waldeir/washing_machine/wash_machine.sch

## EAGLE design wash_machine.sch (2021-09-11)

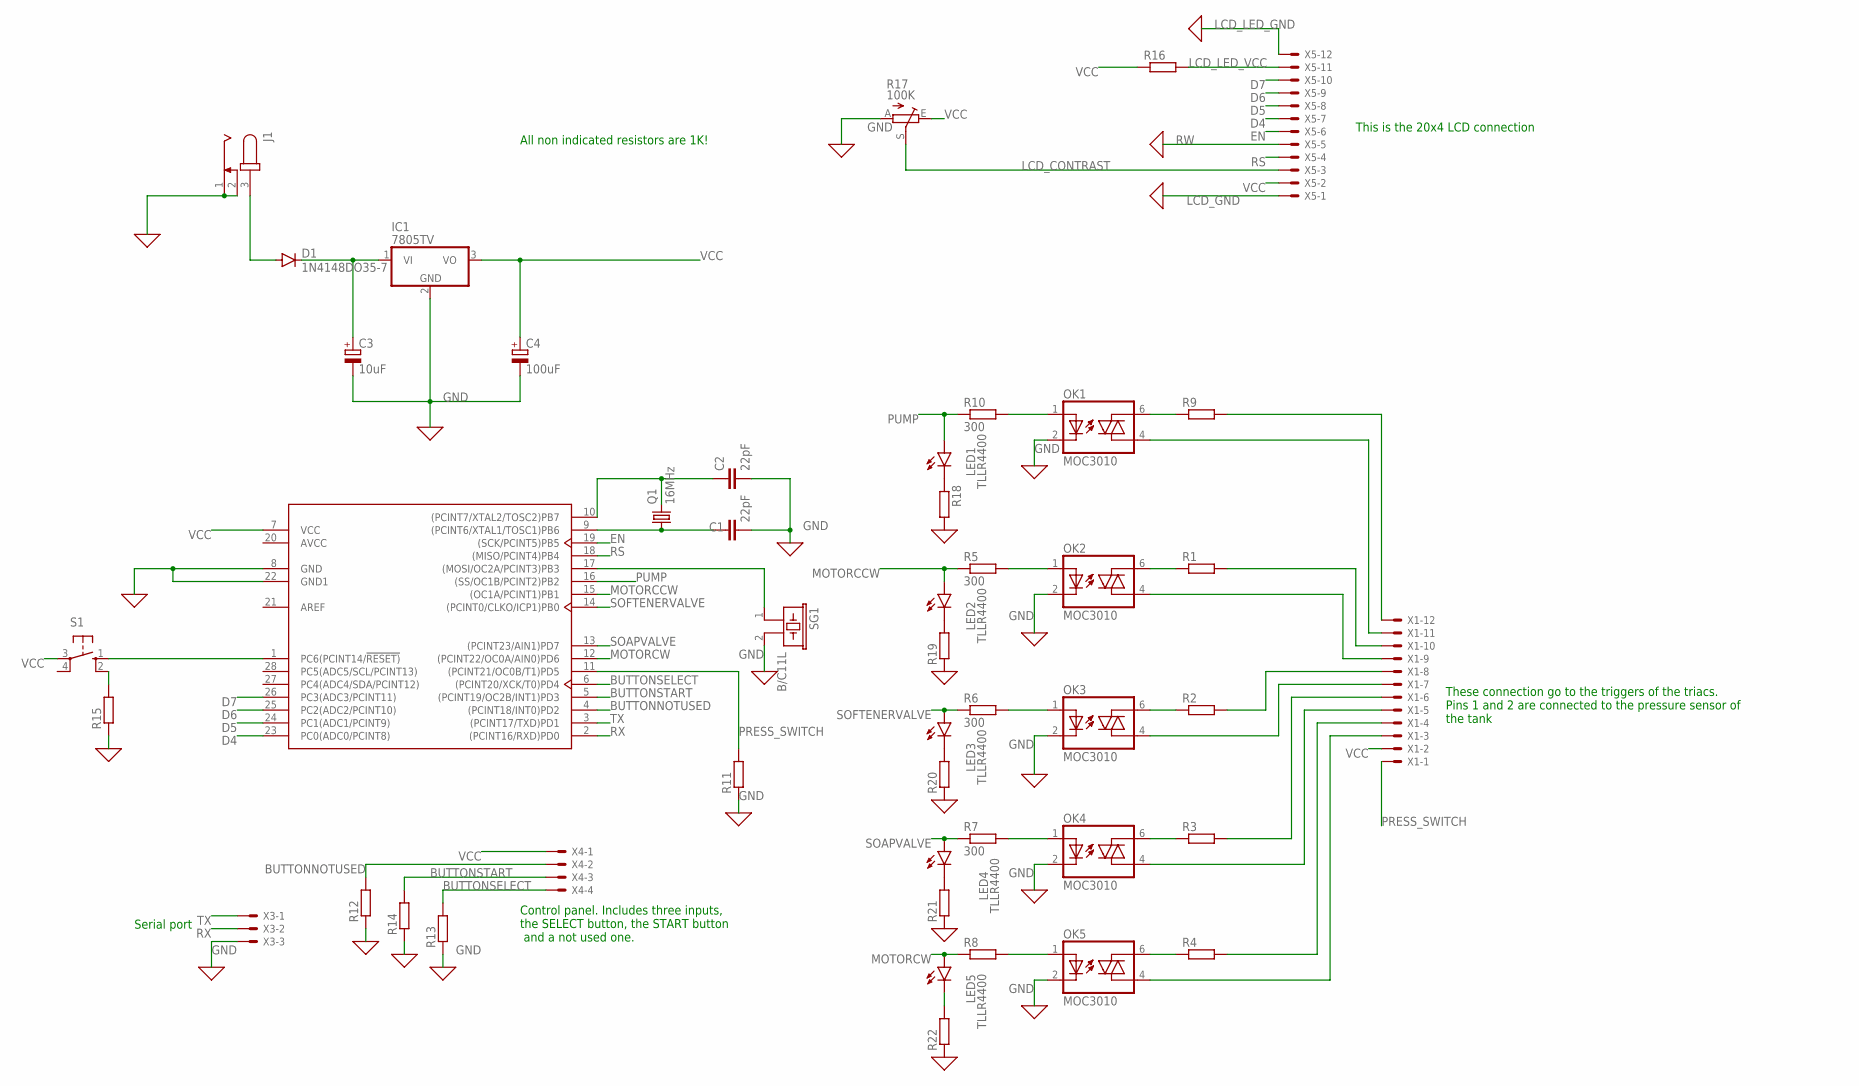
[picture p1: schematic wash_machine.sch]

Parts:
C1, C2: 22pF; C2.5-3
C3: 10uF; B45181A
C4: 100uF; B45181A
D1: 1N4148DO35-7; DO35-7
IC1: 7805TV; TO220V
J1: JACK-PLUG0; SPC4077
LED1, LED2, LED3, LED4, LED5: TLLR4400; LED3MM
OK1, OK2, OK3, OK4, OK5: MOC3010; DIL06
Q1: 16MHz; HC49U-V
R1, R2, R3, R4, R8, R9, R11, R12, R13, R14, R15, R16, R18, R19, R20, R21, R22: R-EU_0204/7; 0204/7
R5, R6, R7, R10: 300; 0204/7
R17: 100K; B25U
S1: 10-XX; B3F-10XX
SG1: B/C11L
U1: ATMEGA328P-PU; DIP-28
X1, X5: KK-156-12
X3: KK-156-3
X4: KK-156-4

Connections:
BUTTONNOTUSED: R12.2, U1.4 ((PCINT18/INT0)PD2), X4.2
BUTTONSELECT: R13.2, U1.6 ((PCINT20/XCK/T0)PD4), X4.4
BUTTONSTART: R14.2, U1.5 ((PCINT19/OC2B/INT1)PD3), X4.3
D4: U1.23 (PC0(ADC0/PCINT8)), X5.7
D5: U1.24 (PC1(ADC1/PCINT9)), X5.8
D6: U1.25 (PC2(ADC2/PCINT10)), X5.9
D7: U1.26 (PC3(ADC3/PCINT11)), X5.10
EN: U1.19 ((SCK/PCINT5)PB5), X5.6
GND: C1.2, C2.2, C3.-, C4.-, IC1.2 (GND), J1.1, J1.2, OK1.2 (C), OK2.2 (C), OK3.2 (C), OK4.2 (C), OK5.2 (C), R11.1, R12.1, R13.1, R14.1, R15.1, R17.A, R18.2, R19.1, R20.1, R21.1, R22.1, SG1.2, U1.8 (GND), U1.22 (GND1), X3.3
LCD_CONTRAST: R17.S, X5.3
LCD_GND: X5.1
LCD_LED_GND: X5.12
LCD_LED_VCC: R16.2, X5.11
MOTORCCW: LED2.A, R5.1, U1.15 ((OC1A/PCINT1)PB1)
MOTORCW: LED5.A, R8.1, U1.12 ((PCINT22/OC0A/AIN0)PD6)
unnamed: D1.A, J1.3
unnamed: C3.+, D1.C, IC1.1 (VI)
unnamed: SG1.1, U1.17 ((MOSI/OC2A/PCINT3)PB3)
unnamed: OK5.1 (A), R8.2
unnamed: C1.1, Q1.1, U1.9 ((PCINT6/XTAL1/TOSC1)PB6)
unnamed: C2.1, Q1.2, U1.10 ((PCINT7/XTAL2/TOSC2)PB7)
unnamed: OK4.1 (A), R7.2
unnamed: OK3.1 (A), R6.2
unnamed: OK2.1 (A), R5.2
unnamed: OK1.6 (A2), R9.1
unnamed: OK2.6 (A2), R1.1
unnamed: OK3.6 (A2), R2.1
unnamed: OK4.6 (A2), R3.1
unnamed: OK1.1 (A), R10.2
unnamed: OK5.6 (A2), R4.1
unnamed: R9.2, X1.12
unnamed: OK1.4 (A1), X1.11
unnamed: R1.2, X1.10
unnamed: OK2.4 (A1), X1.9
unnamed: R2.2, X1.8
unnamed: OK3.4 (A1), X1.7
unnamed: R3.2, X1.6
unnamed: OK4.4 (A1), X1.5
unnamed: R4.2, X1.4
unnamed: OK5.4 (A1), X1.3
unnamed: S1.1 (S), U1.1 (PC6(PCINT14/!RESET))
unnamed: R15.2, S1.2 (S1)
unnamed: LED1.K (C), R18.1
unnamed: LED2.K (C), R19.2
unnamed: LED3.K (C), R20.2
unnamed: LED4.K (C), R21.2
unnamed: LED5.K (C), R22.2
PRESS_SWITCH: R11.2, U1.11 ((PCINT21/OC0B/T1)PD5), X1.1
PUMP: LED1.A, R10.1, U1.16 ((SS/OC1B/PCINT2)PB2)
RS: U1.18 ((MISO/PCINT4)PB4), X5.4
RW: X5.5
RX: U1.2 ((PCINT16/RXD)PD0), X3.2
SOAPVALVE: LED4.A, R7.1, U1.13 ((PCINT23/AIN1)PD7)
SOFTENERVALVE: LED3.A, R6.1, U1.14 ((PCINT0/CLKO/ICP1)PB0)
TX: U1.3 ((PCINT17/TXD)PD1), X3.1
VCC: C4.+, IC1.3 (VO), R16.1, R17.E, S1.3, U1.7 (VCC), X1.2, X4.1, X5.2

Notes on the sheet:
This is the 20x4 LCD connection
Serial port
Control panel. Includes three inputs, the SELECT button, the START button and a not used one.
These connection go to the triggers of the triacs. Pins 1 and 2 are connected to the pressure sensor of the tank
All non indicated resistors are 1K!
