waldeir/washing_machine/(commit log)

2018-07-05 I noticed that the sprints off time at centrifugation step were too long so I decrease them.
    [washing_machine.ino]
2018-07-20 Eliminating serial print for Time.
2018-07-27 Adding error message in case the tank take too long to fill.
    [washing_machine.ino]
2018-07-31 Print the firmware version.
2018-07-31 Menu list and firmware print correction.
    [washing_machine.ino]
2018-08-15 Corrected:
    Valve not stopping after error message;
    Name of cicle "ENXAGUE DUPLO" is displaying as "ENXAGUE SIMPLES";
    "LAVAGEM COMPLETA" cycle finishes too early.
    [washing_machine.ino]
2018-12-24 motor pin variable descriptions
2019-07-19 Firmware print current firmware version
2019-07-22 Verify three times if the tank is full, when using the softer valve.
2019-12-15 Improving "Tank Filled" detection for softener valve
2020-02-02 Adding delay after tank level detection, to avoid miss detection
    [washing_machine.ino]
2020-09-20 Let the water valve open by 12 min before start the tank level verification.
2020-09-27 Reading pressostato state correctly
    [washing_machine.ino]
2020-09-27 New Shaking LCD message.
    New Shaking LCD message. "Washing" Serial message was broken into "Shaking" and
    "Soak" messages.
    [washing_machine.ino]
2020-09-27 Using F() macro to store string in Program Memory and save RAM. This corrected the message "Low memory available, stability problems may occur."
    [washing_machine.ino]
2020-09-27 Print the selected program to the serial port.
2020-09-27 Fixing serial messages spaces
    [washing_machine.ino]
2020-09-27 hits > hitsNumber
    spin > spinTime
    pause > pauseTime
    soak > soakTime
    In funcion wash() :
    i > currentStep
    Adding totalSteps variable
2020-09-28 Measure remaining time using an internal interrupt
2020-09-29 timeTankFull > timeTankFullInMilliseconds
    and
    Fixing variable type mismatch
    [washing_machine.ino]
2020-09-29 Labeling buttons
2020-09-29 Fixing option appearing two times in LCD menu
    [washing_machine.ino]
2020-09-29 Disabling the "print time to serial" feature
2020-12-16 Translat all serial prints to english
2020-12-18 Adding circuit schematics
    [wash_machine.sch]
2021-09-11 Add debug leds
    [wash_machine.sch]
2021-09-11 Correct capacitors names
    [wash_machine.sch]
2021-09-11 Rename ground signal from 0 to GND
    [wash_machine.sch]
